Akshaybunny18/Audio-Amplifier/images/stage2_hw_waveform.png

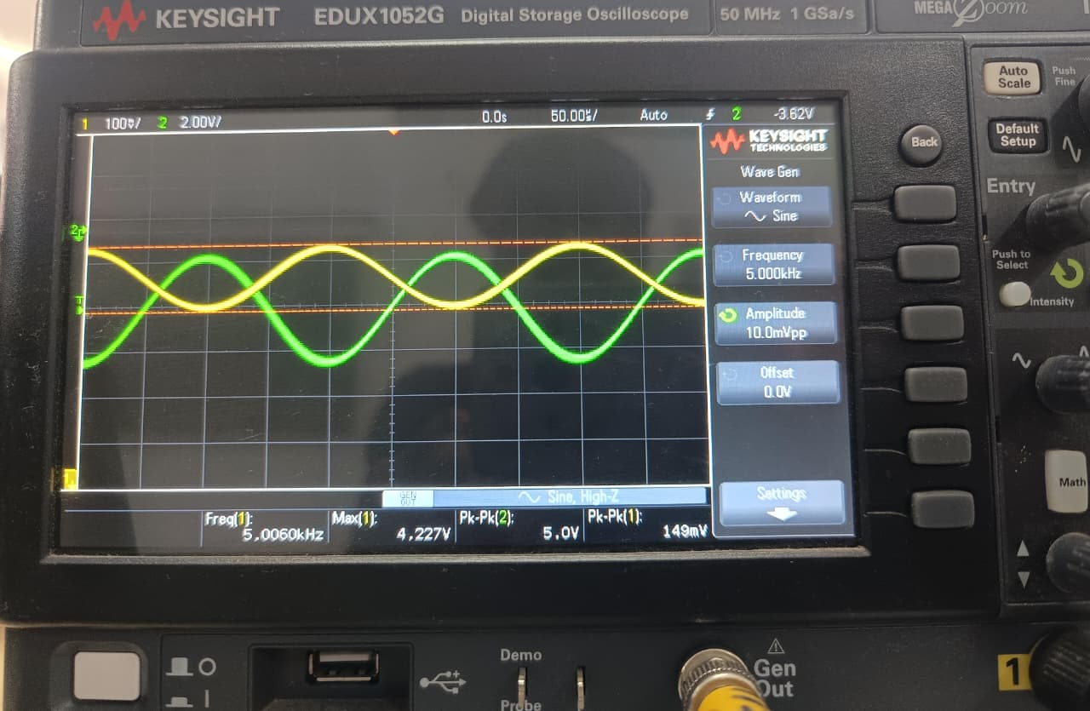
images/stage2_hw_waveform.png
