Akshaybunny18/Audio-Amplifier/images/thd_fft.png

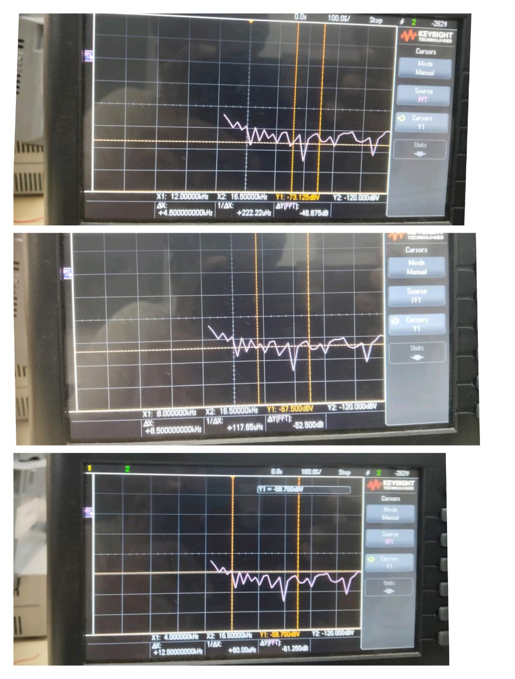
images/thd_fft.png
