Akshaybunny18/Audio-Amplifier/LT_Spice/final.asc

C1: cap; 470µ
C2: cap; 470µ
C3: cap; 3.2p
C4: cap; 6.8n
C5: cap; 22µ
C6: cap; 22µ
CE1: cap; 470µ
D1: diode; 1N4148
D2: diode; 1N4148
Q1: npn; BC547B
Q2: npn; BC547B
Q3: npn; BC547B
Q4: npn; Qtip31a
Q5: pnp; Qtip32a
R1: res; 60
R2: res; 2200k
R3: res; 2200k
R4: res; 900
R5: res; 900
R6: res; 8
RB1: res; 80k
RB2: res; 560k
RC1: res; 400
RC2: res; 400
RE1: res; 15
RE2: res; 1075
RL1: res; 2.5k
U1: opamp2; UA741
V2: voltage; 12
V3: voltage; -12
VDD1: voltage; 5
VEE1: voltage; -5
Vin1: voltage; SINE(0 10m 2k)
Named nets: 0, VEE, VDD, V++, V--, OUT
.tran 0.05
.include "UA741.301"
.ac dec 10 1 400k
.include "tip31a.lib"
.include "tip32a.lib"
