Akshaybunny18/Audio-Amplifier/LT_Spice/pre_final.asc

C1: cap; 470µ
C2: cap; 470µ
C3: cap; 3.2p
C4: cap; 6.8n
C5: cap; 22µ
C6: cap; 22µ
CE1: cap; 470µ
D1: diode; 1N4148
D2: diode; 1N4148
Q1: npn; BC547B
Q2: npn; BC547B
Q3: npn; BC547B
Q4: npn; Qtip31a
Q5: pnp; Qtip32a
R1: res; 60
R2: res; 400
R3: res; 400
R4: res; 1075
R5: res; 2200k
R6: res; 2200k
R7: res; 900
R8: res; 900
R9: res; 8
RB1: res; 80k
RB2: res; 560k
RC1: res; 2.5k
RE1: res; 15
U1: opamp2; UA741
V1: voltage; -5
V2: voltage; SINE(0 10m 5k); AC 1
V3: voltage; -5
V4: voltage; -12
V5: voltage; -12
V6: voltage; 5
V7: voltage; -5
V8: voltage; SINE(0 -5m 2k)
VDD1: voltage; 5
VEE1: voltage; -5
Named nets: VDD, 0, VEE
.include "UA741.301"
.include "tip31a.lib"
.include "tip32a.lib"
.ac dec 500 1 100k
.tran 10m
.four 20k V(n009)
PULSE(-10m 10m 0 1n 1n 5u 10u)
