Akshaybunny18/Audio-Amplifier/LT_Spice/stage1.asc

Q1: npn; BC547B
Q2: npn; BC547B
RC1: res; 400
RC2: res; 400
RE: res; 1075
V1: voltage; 5
VCC: voltage; 5
Vin1: voltage; SINE(0 10m 1000)
Vin2: voltage; 0
Named nets: 0, out
.tran 0.05
