Akshaybunny18/Audio-Amplifier/LT_Spice/stage2.asc

C1: cap; 470µ
C2: cap; 470µ
CE: cap; 470µ
Q3: npn; BC547B
R1: res; 60
RB1: res; 560k
RB2: res; 80k
RC: res; 2.5k
RE: res; 15
V1: voltage; SINE(0 140m 2k)
VDD: voltage; 5
VEE: voltage; -5
Named nets: VDD, 0, VEE
.ac dec 500 1 100k
.tran 10m
PULSE(-10m 10m 0 1n 1n 5u 10u)
