Akshaybunny18/Audio-Amplifier/LT_Spice/stage3.asc

C1: cap; 7.33n
C2: cap; 3.2p
R1: res; 2200k
R2: res; 2200k
U1: opamp2; UA741
V1: voltage; SINE(0 450m 1k); AC 1
V2: voltage; 12
V3: voltage; -12
Named nets: 0, V++, V--
.include "UA741.301"
.ac dec 10 1 400k
.tran 10m
7.33--->6.8p
3.2p--->1p
