Akshaybunny18/Audio-Amplifier/LT_Spice/stage4.asc

C1: cap; 22µ
C2: cap; 22µ
D1: diode; 1N4148
D2: diode; 1N4148
Q1: npn; Qtip31a
Q2: pnp; Qtip32a
R1: res; 900
R2: res; 900
R3: res; 8
V1: voltage; SINE(0 4.5 5k)
VDD1: voltage; 5
VEE1: voltage; -5
Named nets: 0, VEE, VDD
.include "tip31a.lib"
.include "tip32a.lib"
.tran 10m
